1chasemcd/RaspberryTI/images/smaller pcb.jpg

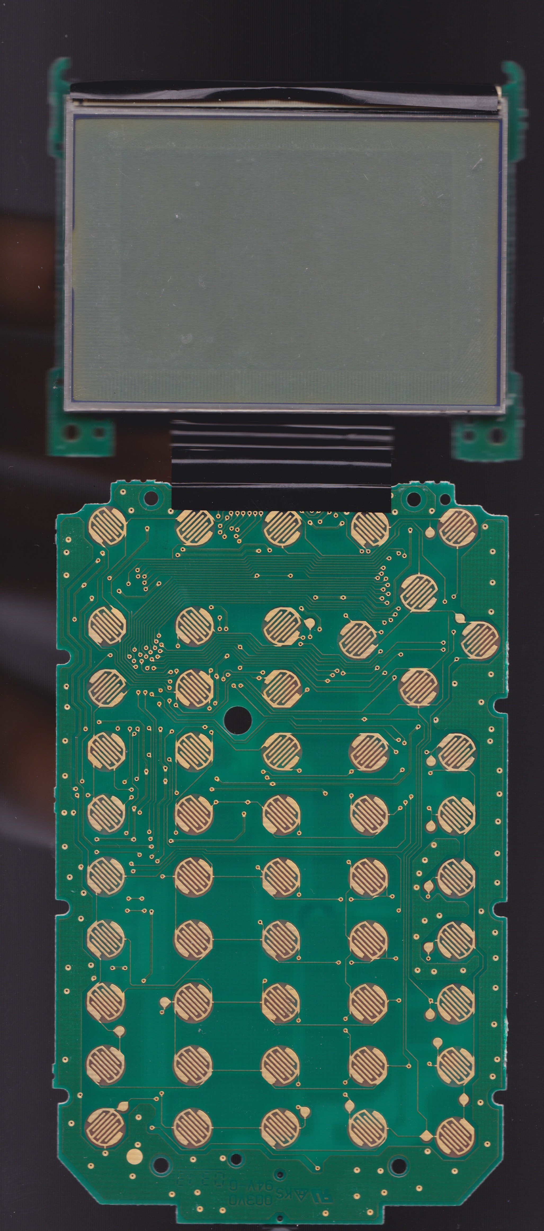
images/smaller pcb.jpg
