1chasemcd/RaspberryTI/README.md

# RaspberryTI

Putting a Raspberry PI in a TI 83. Very much a WIP.
