1chasemcd/RaspberryTI/keypad pcb/pcb outline.dxf

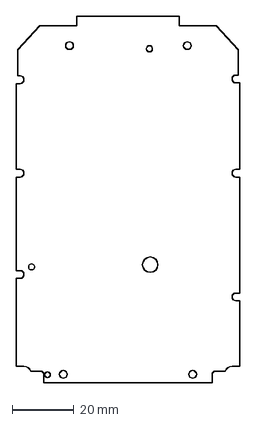
[picture p2: CAD file, 2021-05-12]
keypad pcb/pcb outline.dxf
72.4 x 118.5 mm
