1chasemcd/RaspberryTI/keypad pcb/keypad pcb.sch

## KiCad design keypad pcb/keypad pcb.sch (2021-05-15, an earlier design)

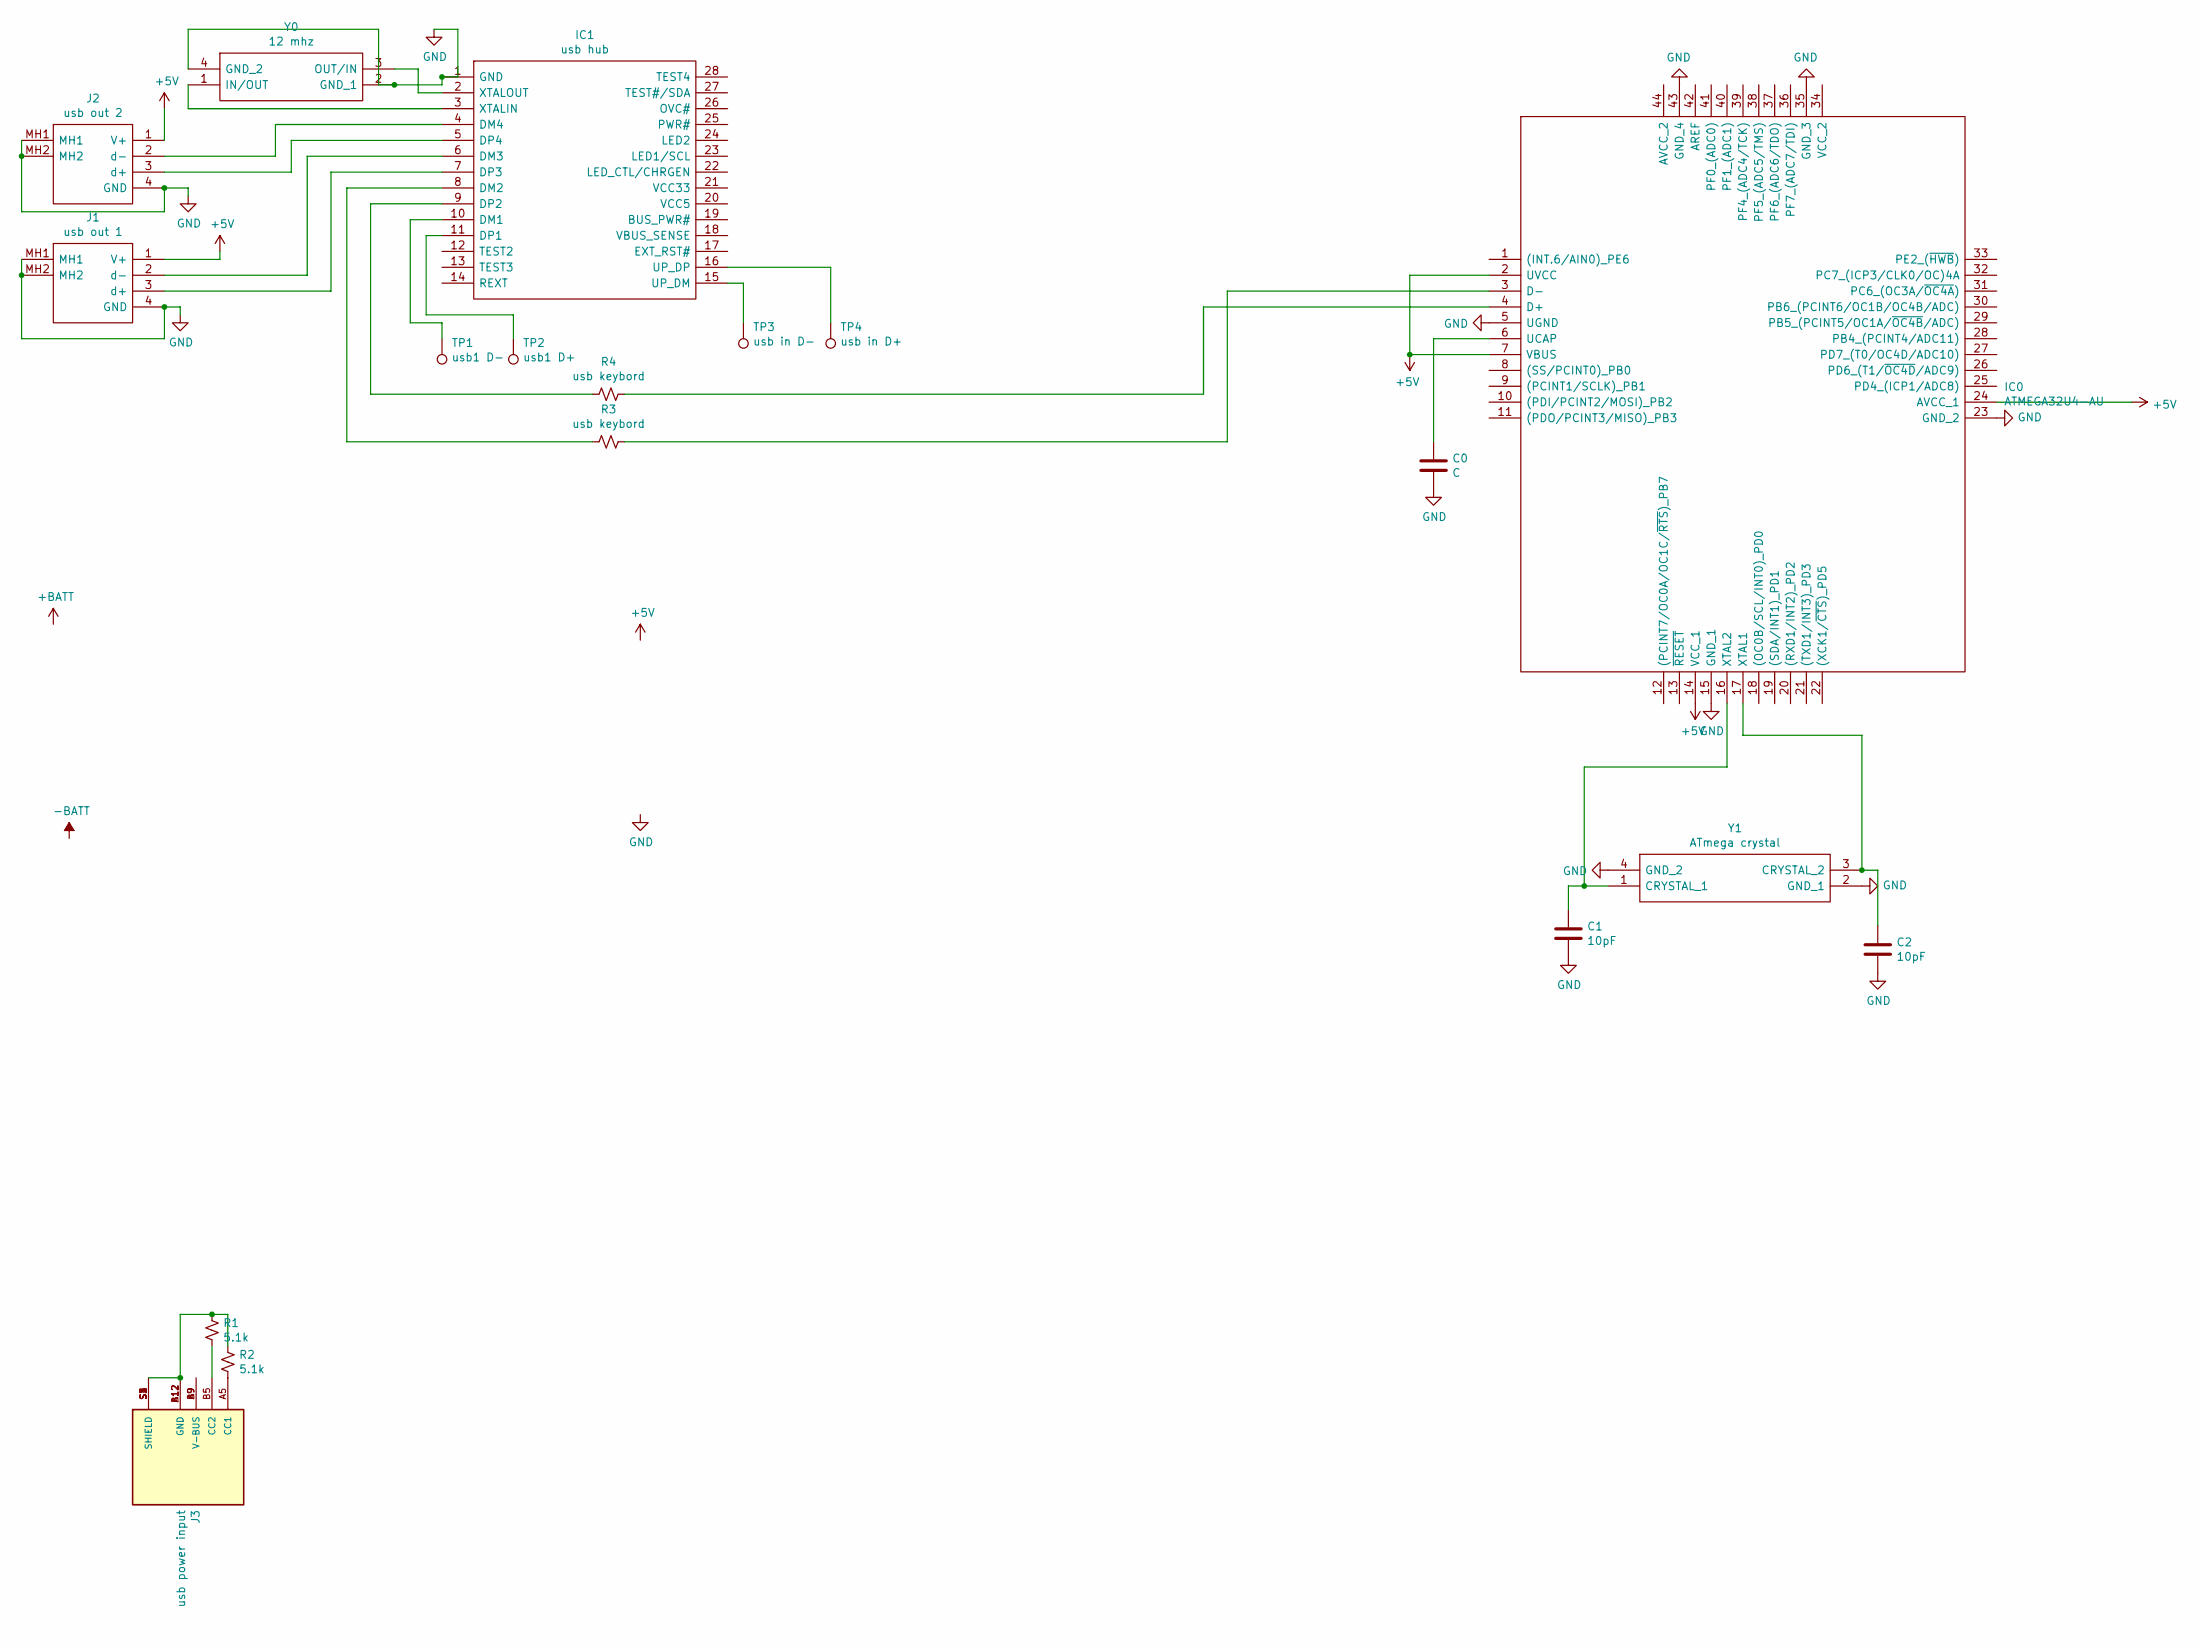
[picture p3: schematic keypad pcb.sch]

Parts:
C0: C
C1, C2: 10pF
IC0: ATMEGA32U4-AU; QFP80P1200X1200X120-44N; Mouser Part Number 556-ATMEGA32U4-AU
IC1: usb hub; SOP64P600X173-28N; Mouser Part Number 701-XR22404CG28TR-F
J1: usb out 1; UJ2AH4TH; Mouser Part Number 490-UJ2-AH-4-TH
J2: usb out 2; UJ2AH4TH; Mouser Part Number 490-UJ2-AH-4-TH
J3: usb power input; CUI_UJC-HP-3-SMT-TR; PARTREV 04/30/2020
R1, R2: 5.1k
R3, R4: usb keybord
TP1: usb1 D-
TP2: usb1 D+
TP3: usb in D-
TP4: usb in D+
Y0: 12 mhz; ECS3201233AGMTR; Mouser Part Number 520-120-18-33-JEMT
Y1: ATmega crystal; TSX3225160000MF18XAC0; Mouser Part Number 732-322516F18XAC0

Connections:
+5V: IC0.2 (UVCC), IC0.7 (VBUS), IC0.14 (VCC_1), IC0.24 (AVCC_1), J1.1 (V+), J2.1 (V+)
GND: C0.2, C1.2, C2.2, IC0.5 (UGND), IC0.15 (GND_1), IC0.23 (GND_2), IC0.35 (GND_3), IC0.43 (GND_4), IC1.1 (GND), J1.4 (GND), J1.MH1, J1.MH2, J2.4 (GND), J2.MH1, J2.MH2, Y0.2 (GND_1), Y0.4 (GND_2), Y1.2 (GND_1), Y1.4 (GND_2)
unnamed: C0.1, IC0.6 (UCAP)
unnamed: C1.1, IC0.16 (XTAL2), Y1.1 (CRYSTAL_1)
unnamed: C2.1, IC0.17 (XTAL1), Y1.3 (CRYSTAL_2)
unnamed: IC0.3 (D-), R3.1
unnamed: IC0.4 (D+), R4.1
unnamed: IC1.2 (XTALOUT), Y0.3 (OUT/IN)
unnamed: IC1.3 (XTALIN), Y0.1 (IN/OUT)
unnamed: IC1.4 (DM4), J2.2 (d-)
unnamed: IC1.5 (DP4), J2.3 (d+)
unnamed: IC1.6 (DM3), J1.2 (d-)
unnamed: IC1.7 (DP3), J1.3 (d+)
unnamed: IC1.8 (DM2), R3.2
unnamed: IC1.9 (DP2), R4.2
unnamed: IC1.10 (DM1), TP1.1
unnamed: IC1.11 (DP1), TP2.1
unnamed: IC1.15 (UP_DM), TP3.1
unnamed: IC1.16 (UP_DP), TP4.1
unnamed: J3.A5 (CC1), R2.2
unnamed: J3.A9 (V-BUS), J3.B9 (V-BUS)
unnamed: J3.A12 (GND), J3.B12 (GND), J3.S1 (SHIELD), J3.S2 (SHIELD), J3.S3 (SHIELD), J3.S4 (SHIELD), R1.1, R2.1
unnamed: J3.B5 (CC2), R1.2
