1chasemcd/RaspberryTI/(commit log)

2021-05-12 added files and updated readme
    [keypad pcb.kicad_pcb, keypad pcb.sch, pcb outline.dxf]
2021-05-15 Add keyboard switches
    [keypad pcb.sch]
2021-05-15 added adafruit powerboost
    [keypad pcb.sch]
